ttseng/Pix/README.md

# Pix
Pix is a Raspberry Pi-based press-to-print documentation system.



Find complete instructions for creating your own Pix here: https://ttseng.github.io/Pix/
