ttseng/Pix/docs/images/line_art.png

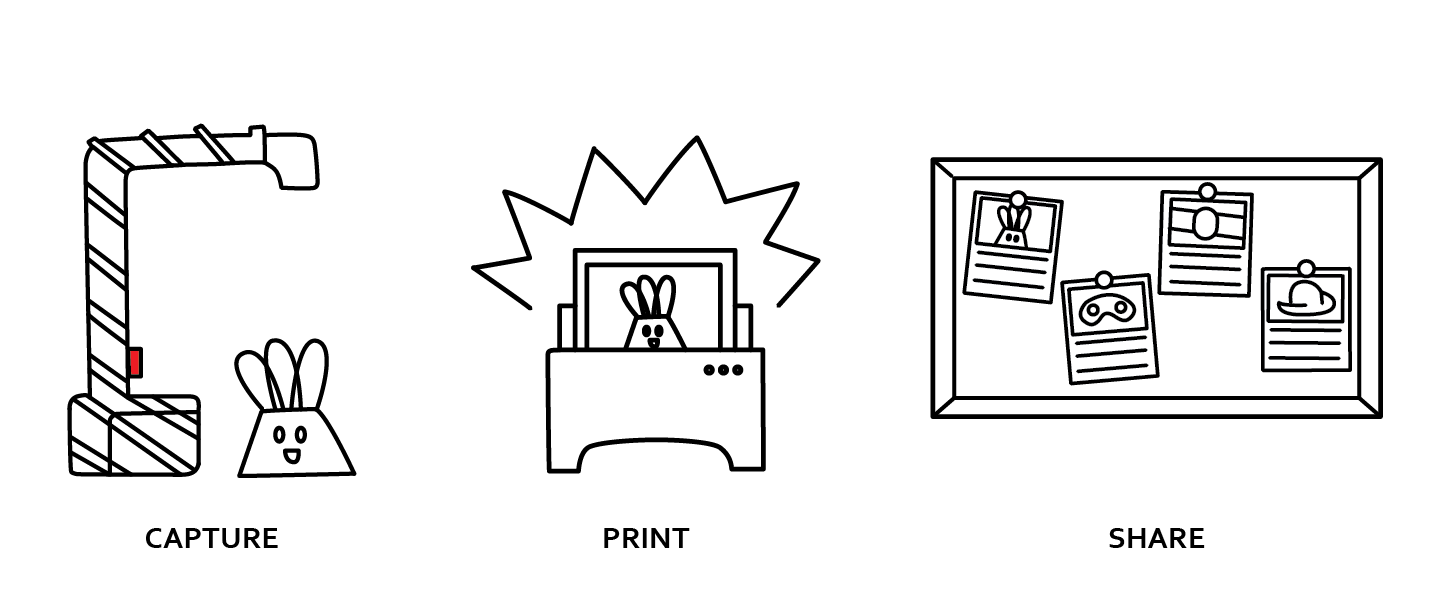
docs/images/line_art.png
