ttseng/Pix/Fabrication/camera_holder.STL

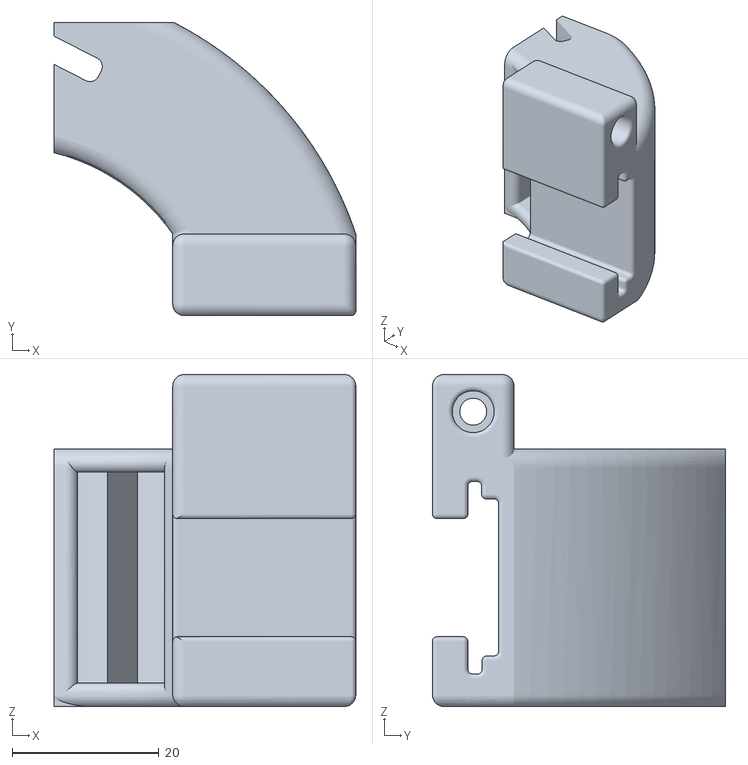
[picture p2: CAD file, 2016-08-23]
Fabrication/camera_holder.STL
41.2 x 40.0 x 45.3
