ttseng/Pix/docs/build_intro.html

Beta

# Build Pix: Intro

## Press-to-Print Documentation System

Intro Fabricate Pix Setup Raspberry Pi Using Pix

## Overview

Pix is built on Raspberry Pi and prints photos you can physically organize and share. You'll need a printer for the full functionality!

If you are building a Pix completely from scratch, you will also need to use a laser cutter and a 3D printer. If you don't have access to either of these tools, don't worry – you can order the parts from Ponoko and Shapeways!

At a minimum, you'll need to use these tools:

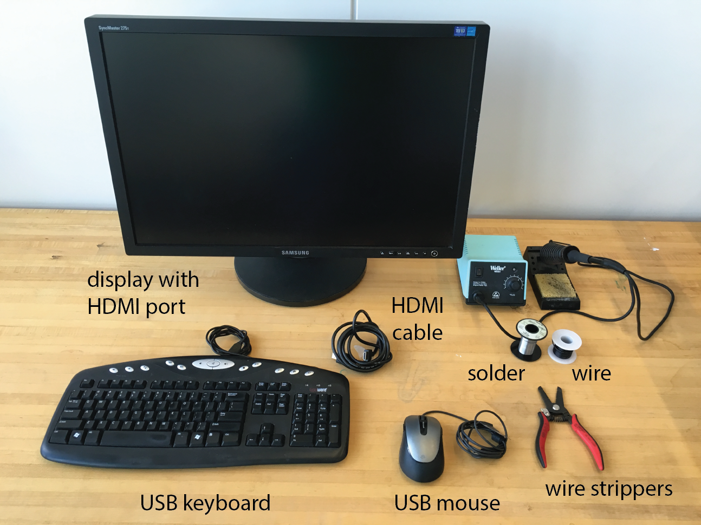
[picture p15: docs/images/tools.png]


Display with HDMI port, HDMI cable, USB keyboard, USB mouse, soldering iron, solder, wire, wire strippers.

## Parts

Below is a list of hardware you'll need for your Pix, all of which can be purchased from Adafruit.

Part | Price
Raspberry Pi 3 Model B (https://www.adafruit.com/products/998) | $39.95
Micro SD Card with NOOBS preinstalled (https://www.adafruit.com/products/1583) | $14.95
Raspberry Pi Camera Board V2 (https://www.adafruit.com/products/3099) | $29.95
Button (https://www.adafruit.com/products/473) | $2.95
MicroUSB Charger (https://www.adafruit.com/products/1995) | $7.95
Female headers (https://www.adafruit.com/products/2886) | $0.95
Total | $96.70
Add all the items to a cart! (http://www.adafruit.com/wishlists/411156)

You will also want to have a regular through-hole LED. These cost pennies each. If you don't have one lying around, here's a link to a pack of 25 from Adafruit: https://www.adafruit.com/products/299

Have all the parts? Let's get started!

Fabricate Pix

Pix (https://github.com/ttseng/PIx) is maintained by ttseng (https://github.com/ttseng) in collaboration with HATCH (https://github.com/wfplhatch/), with support from the Harvard Library Innovation Lab and the MIT Media Lab (https://www.google.com/url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).
This page was generated by GitHub Pages (https://pages.github.com) using the Cayman theme (https://github.com/jasonlong/cayman-theme) by Jason Long (https://twitter.com/jasonlong).
