ttseng/Pix/docs/build_using_pix.html

Beta

# Using Pix

## Press-to-Print Documentation System

Intro Fabricate Pix Setup Raspberry Pi Using Pix

## Using Pix

We've been trying out Pix at the HATCH (http://www.watertownlib.org/hatch) makerspace in Watertown to make it easier for people to share what they're working on. We use Pix along with a whiteboard for people to post images and annotations of their projects:

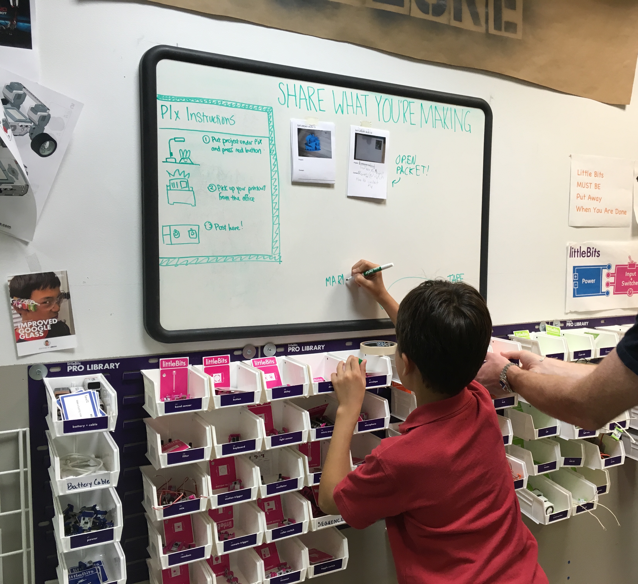
[picture p32: docs/images/using/whiteboard.jpg]


To help people get started, I created this small sign that is posted right next to Pix:

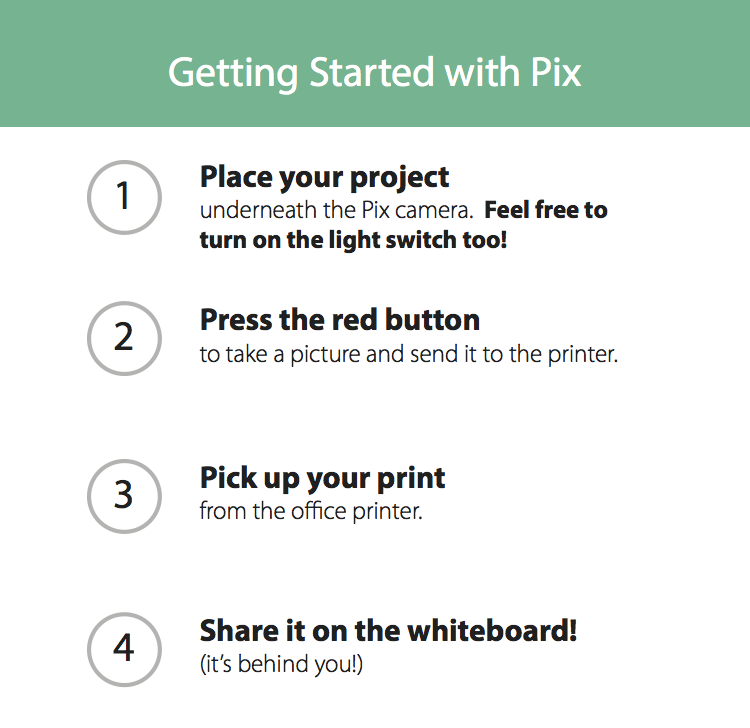
[picture p33: docs/images/using/pix_sign.png]


Pix signage [ PDF | PNG | AI ]

I recommend taping a white backdrop (14.5"x11") on the table underneath Pix. Optionally, you can use a small clip lamp to provide additional lighting:

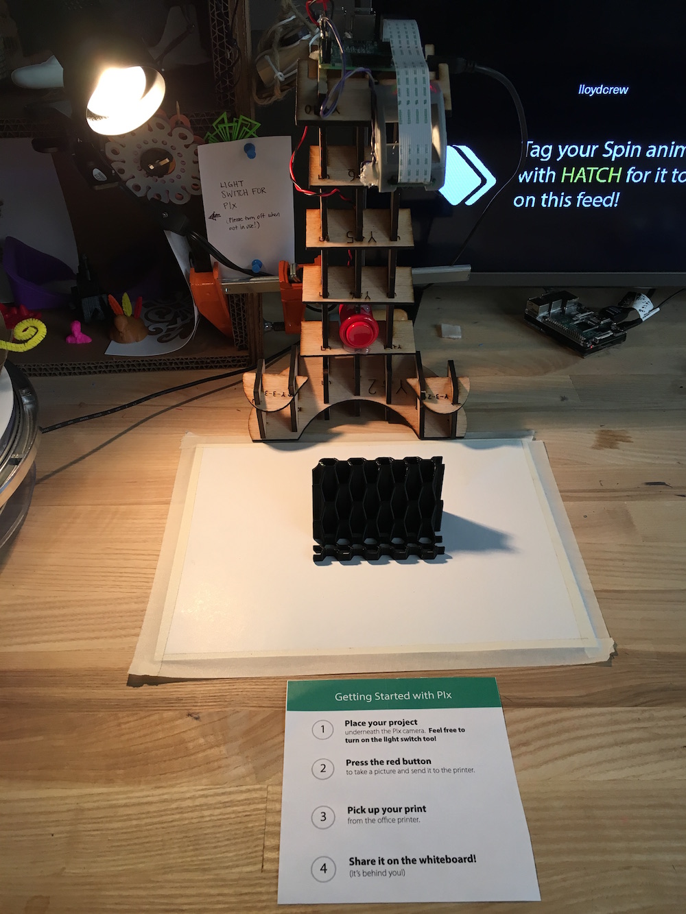
[picture p34: docs/images/using/pix_setup.jpg]


The current Pix setup at HATCH

Feel free to extend Pix in any and all ways. If you do something new with Pix, please share with #madewithpix! (https://twitter.com/search?q=%23madewithpix&src=typd)

If you run into any problems, please report the issue (https://github.com/ttseng/PIx/issues).

Happy documenting!

Pix (https://github.com/ttseng/PIx) is maintained by ttseng (https://github.com/ttseng) in collaboration with HATCH (https://github.com/wfplhatch/), with support from the Harvard Library Innovation Lab and the MIT Media Lab (https://www.google.com/url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).
This page was generated by GitHub Pages (https://pages.github.com) using the Cayman theme (https://github.com/jasonlong/cayman-theme) by Jason Long (https://twitter.com/jasonlong).
