ttseng/Pix/docs/images/setup_pi/ip_address.png

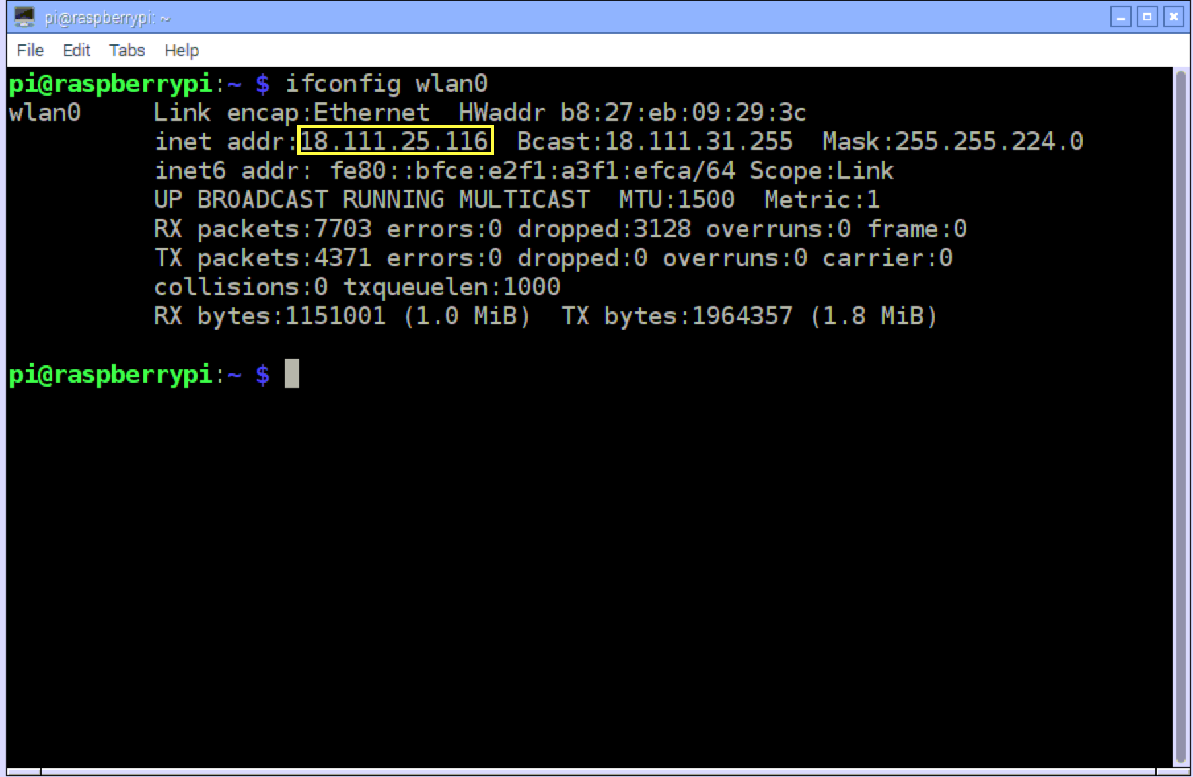
docs/images/setup_pi/ip_address.png
