ttseng/Pix/(commit log)

2016-08-16 updated pix python script for button debounce
2016-08-16 fixed bug with button detection
    [pix.py]
2016-08-23 added pix documentation
    [camera_holder.STL]
